id-studiolab/openflash/Electronics/OpenFlashShield_BillOfMaterials.pdf

## Partlist: Open Flash Shield

Qty | Reference | Part Number | Manufacturer | Distributor | Description | Footprint | Price | Line price
2 C1-2 | MCCA000543 | Multicomp | Farnell 1759422 | MLCC, Y5V, 6.3V, 1UF | 805 | € | 0,01 | € | 0,02
1 IC1 | A000053 | Arduino | RS-stocknr. 771-7667 | ARDUINO_MICRO | DIL-34 | € 19,81 | € 19,81
1 IC1a | A000071 | Arduino | RS-stocknr. 758-9342 | USB Micro cable | | | | € | 2,98
2 IC1b | 2212S-18SG-85 | Multicomp | Farnell 1593467 | SOCKET, PCB, 1 ROW, 18WAY | SIL-18 | € | 0,77 | € | 1,54
1 IC2 | TC1262-5.0VDB | Microchip | Farnell 1852185 | LDO, 500MA, 5.0V | SOT223-3 | € | 0,49 | € | 0,49
4 J2 J5-6 J8 | 70543-0002 | Molex | RS 679-2477P | 2.54mm,header,Cgrid,shrouded,vert,3w | € | 0,43 | € | 1,74
2 J3/4 J7/9 | 70543-0006 | Molex | Farnell 2063771 | HEADER, 2.54MM, 7WAY | | € | 1,13 | € | 2,26
2 J3/4b J7/9b | 50-‐57-‐9407 | Molex | Farnell
| | | 1756906 | HOUSING,

2.54MM,

| | | | 7WAY | | € | 0,43 | € | 0,86
12 J3/4a J7/9a | 16-02-0082 | Molex | Farnell 1756731 | CRIMP

TERMINAL,

FEMALE,

| | | | 24-‐30AWG | | € | 0,03 | € | 0,32
1 BAT_1 | | | Conrad 615579 - 89 | Batterijhouder D voor 4 penlites | | € | 1,75 | € | 1,75
1 BAT_2 | | | Conrad 624691 - 89 | Batterijclip voor 9V-blok | | € | 0,48 | € | 0,48
4 BAT_3 | MX1500 | Duracell | Conrad 650766 - 89 | Duracell Ultra Power batterijen AA 24st | | € | 0,63 | € | 2,52
1 PCB | E537830 | | Eurocircuits | Open Slave Shield | | € | 3,03 | € | 3,03
totaal | € 37,80
