id-studiolab/openflash/Electronics/OpenFlash_Shield_Schematic.pdf

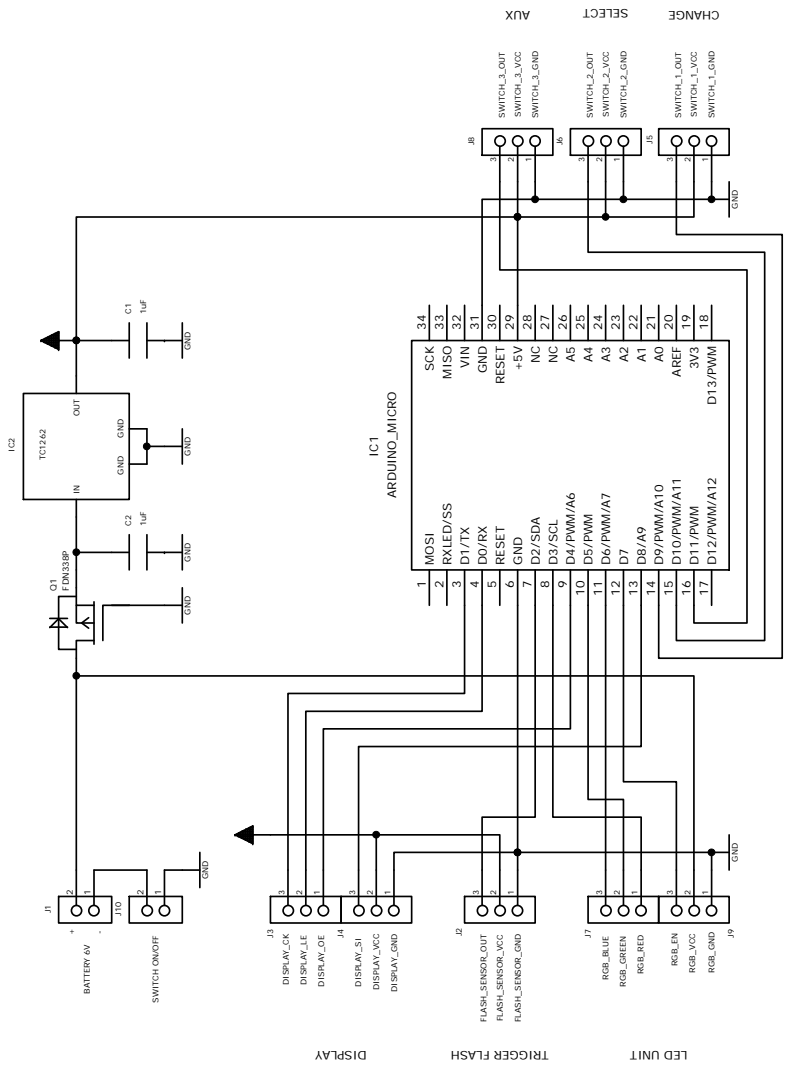
[picture p1: page 1]

34 SCK 33 MISO 32 VIN 31 GND 30 RESET 29 +5V 28 NC 27 NC 26 A5 25 A4 24 A3 23 A2 22 A1 21 A0 20 AREF 19 3V3 18 D13/PWM

1 MOSI 2 RXLED/SS 3 D1/TX 4 D0/RX 6 GND 7 D2/SDA 8 D3/SCL 9 D4/PWM/A6 10 D5/PWM 11 D6/PWM/A7 12 D7 13 D8/A9 14 D9/PWM/A10 15 D10/PWM/A11 16 D11/PWM 17 D12/PWM/A12 5 RESET
