id-studiolab/openflash/Electronics/OpenFlash_Schematic.pdf

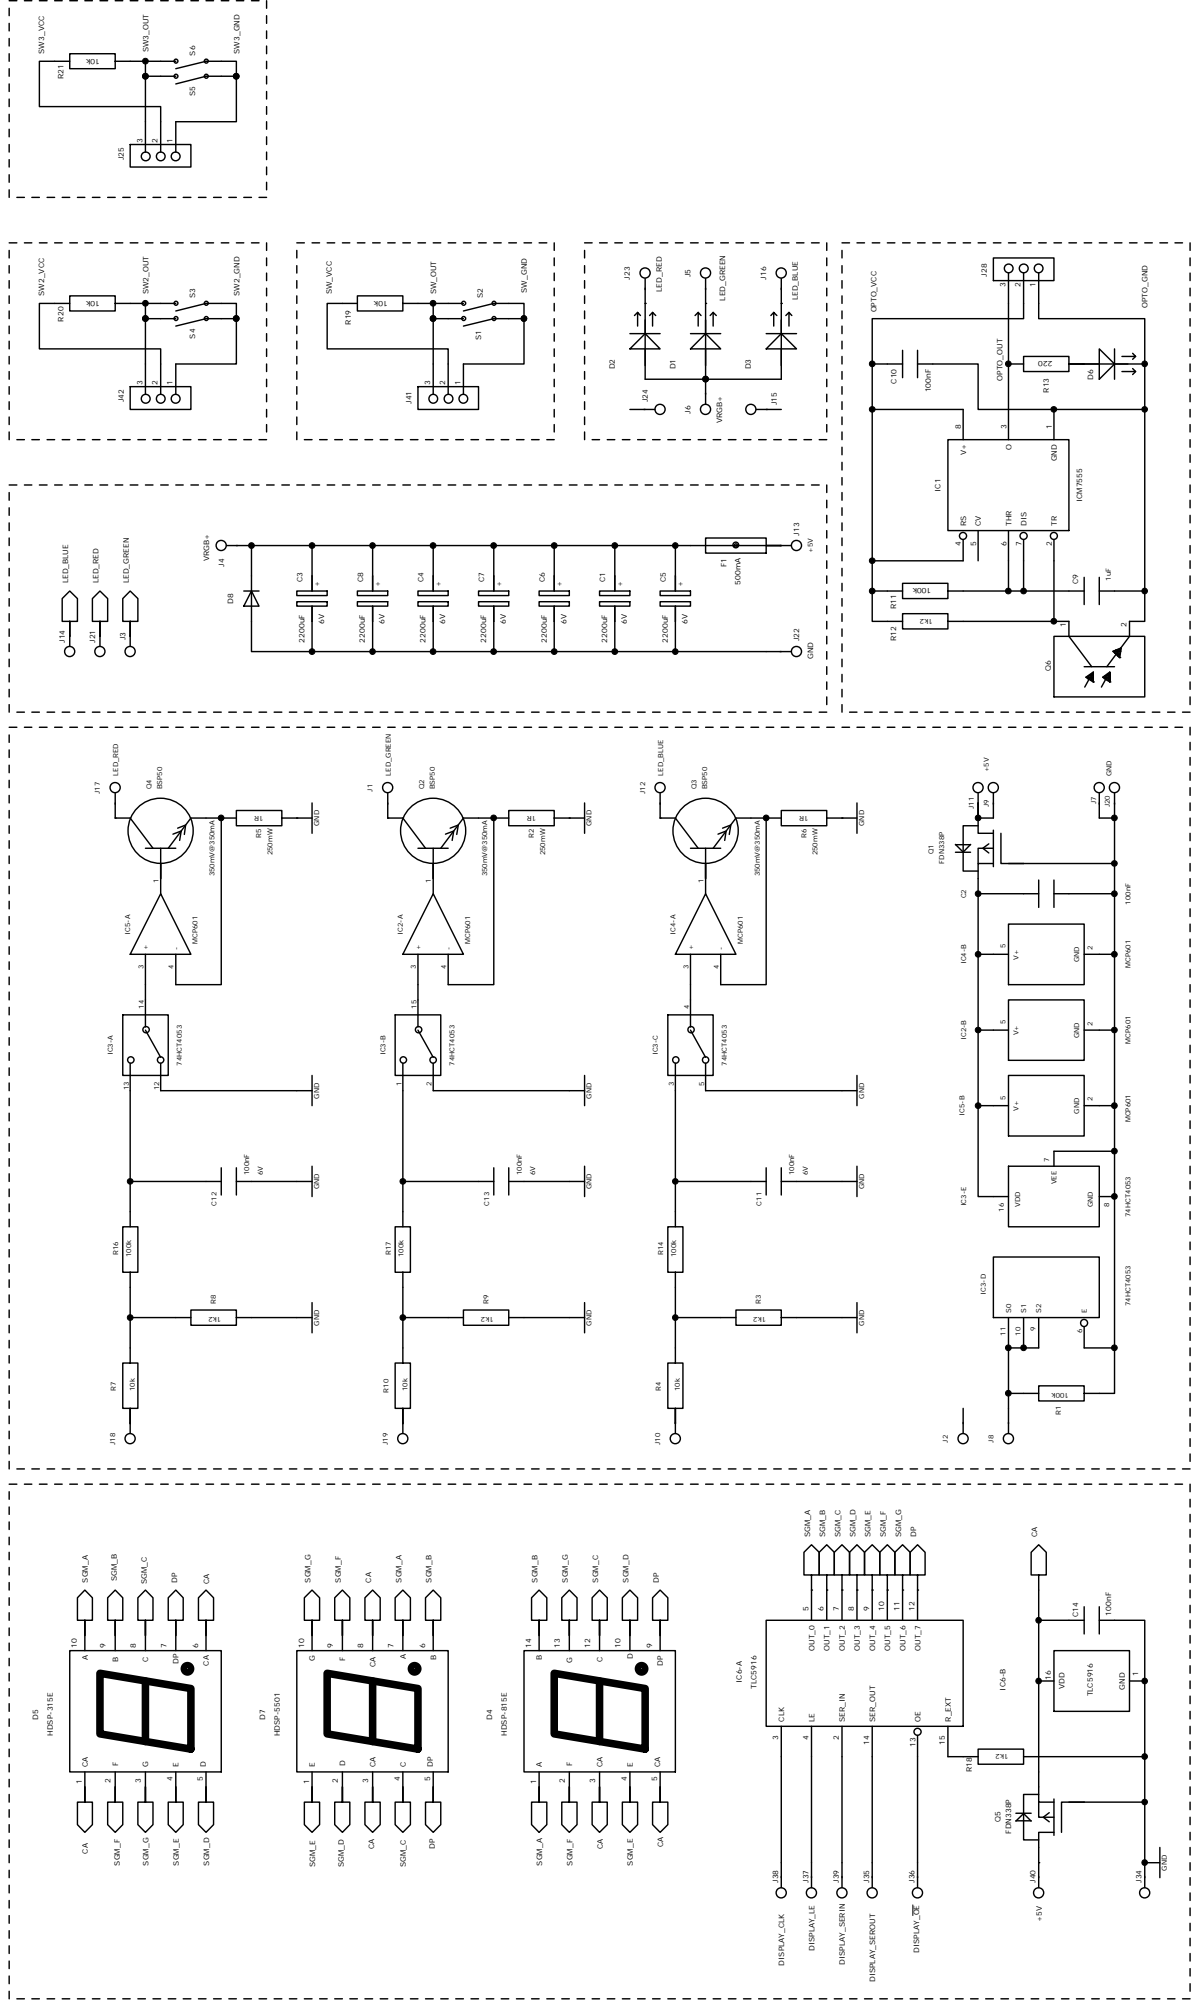
[picture p2: page 1]

GND GND
