id-studiolab/openflash/(commit log)

2013-03-17 Added hooks for aux switch
2013-03-18 Fixed low intensity display problem
    [Advanced.h, Initialize.h]
